Rishi-Saraf/Music-visualiser/figures/fig01_uncertainty.png

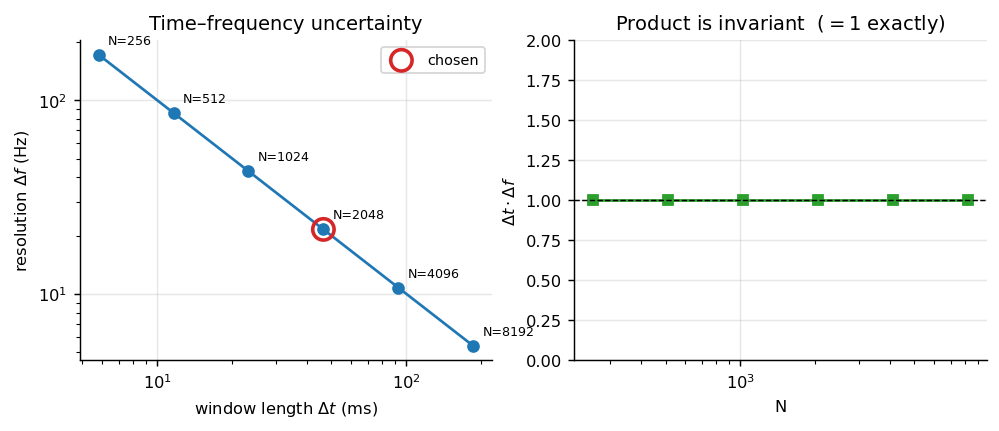
figures/fig01_uncertainty.png
