Rishi-Saraf/Music-visualiser/figures/fig02_window_leakage.png

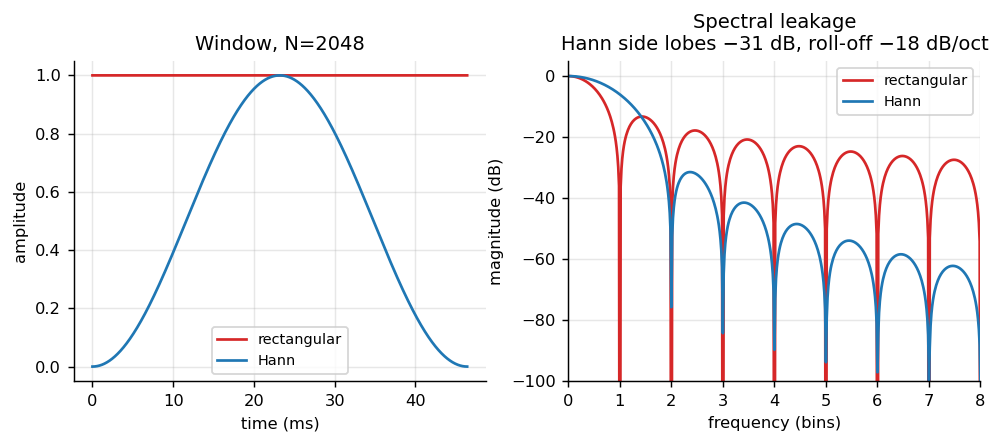
figures/fig02_window_leakage.png
