Rishi-Saraf/Music-visualiser/figures/fig03_spectrogram.png

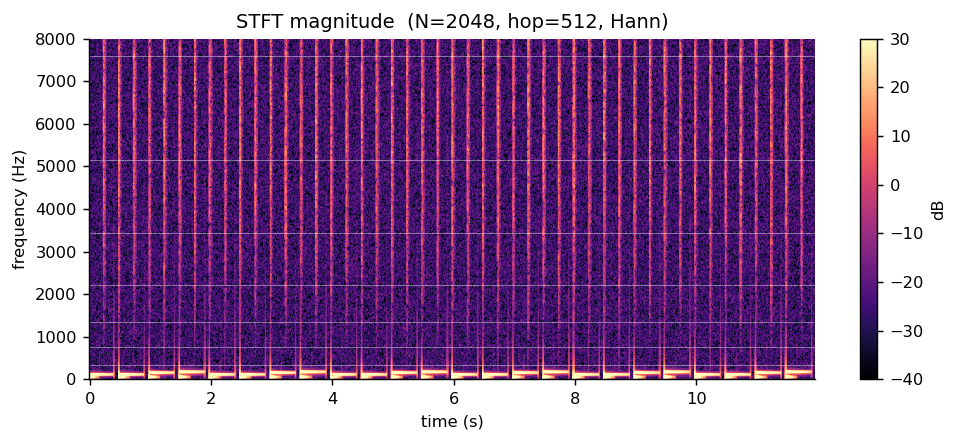
figures/fig03_spectrogram.png
