Rishi-Saraf/Music-visualiser/figures/fig04_filterbank.png

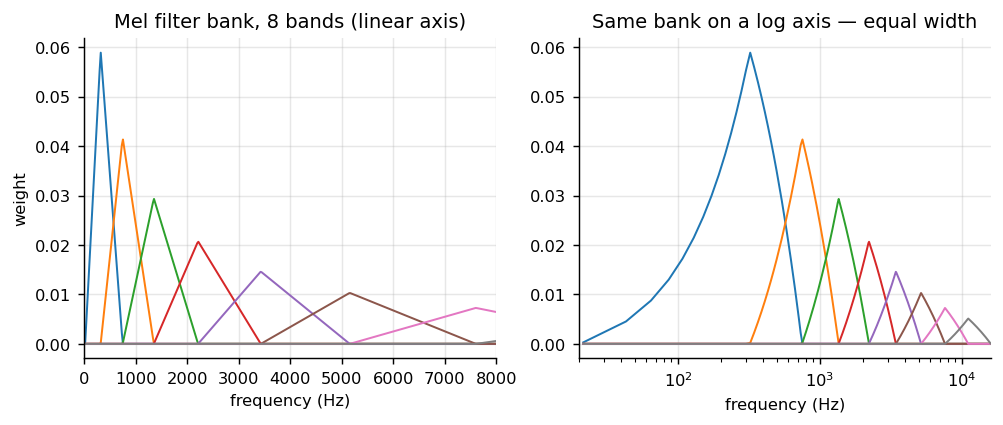
figures/fig04_filterbank.png
