Rishi-Saraf/Music-visualiser/figures/fig05_envelope_lti.png

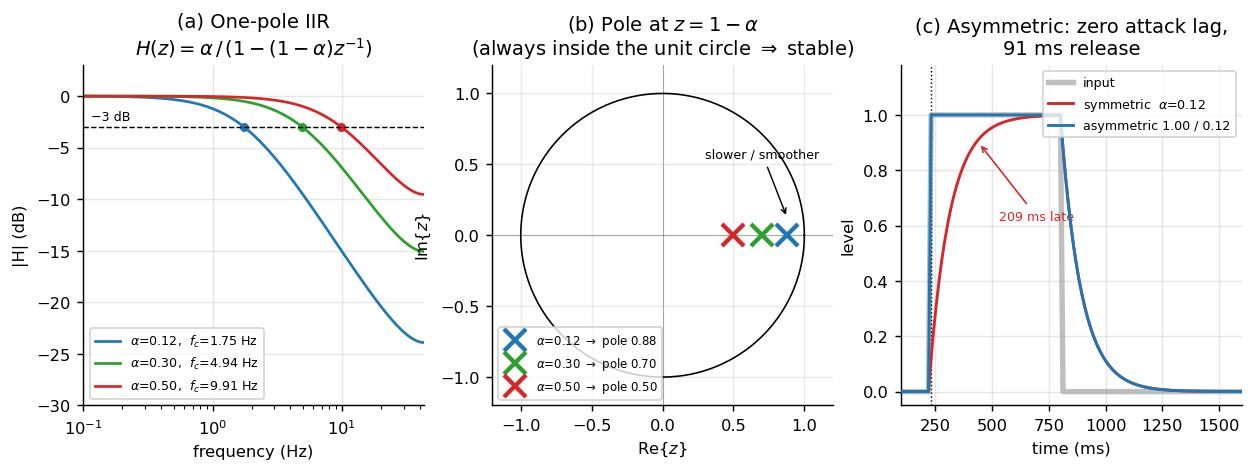
figures/fig05_envelope_lti.png
