Rishi-Saraf/Music-visualiser/figures/fig06_onset_tempo.png

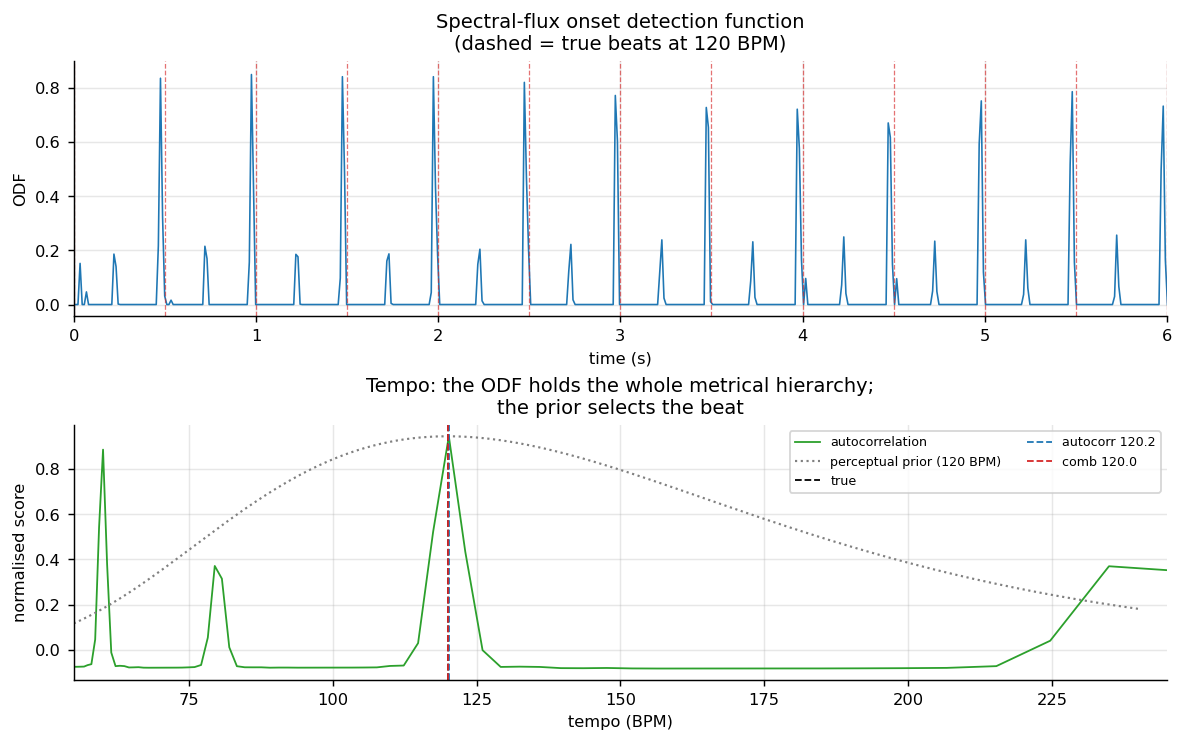
figures/fig06_onset_tempo.png
