Rishi-Saraf/Music-visualiser/figures/fig07_led_waterfall_bars.png

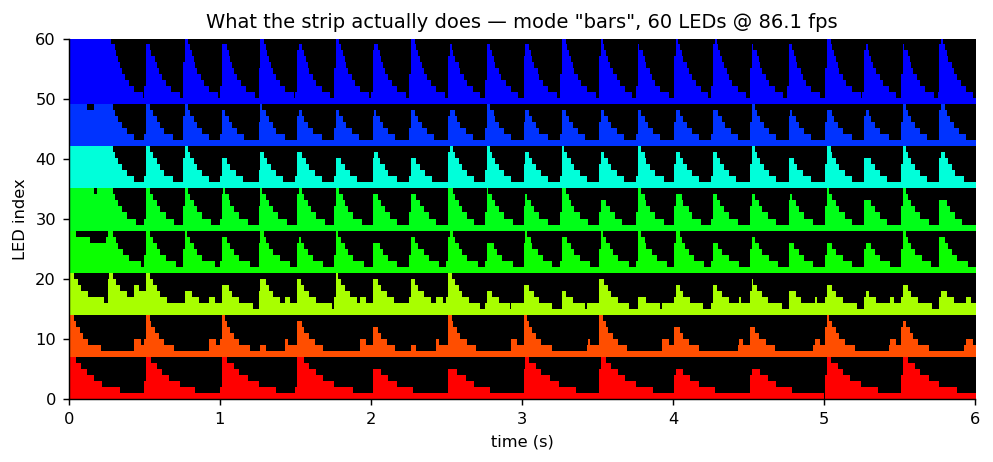
figures/fig07_led_waterfall_bars.png
