Rishi-Saraf/Music-visualiser/figures/fig07_led_waterfall_centroid.png

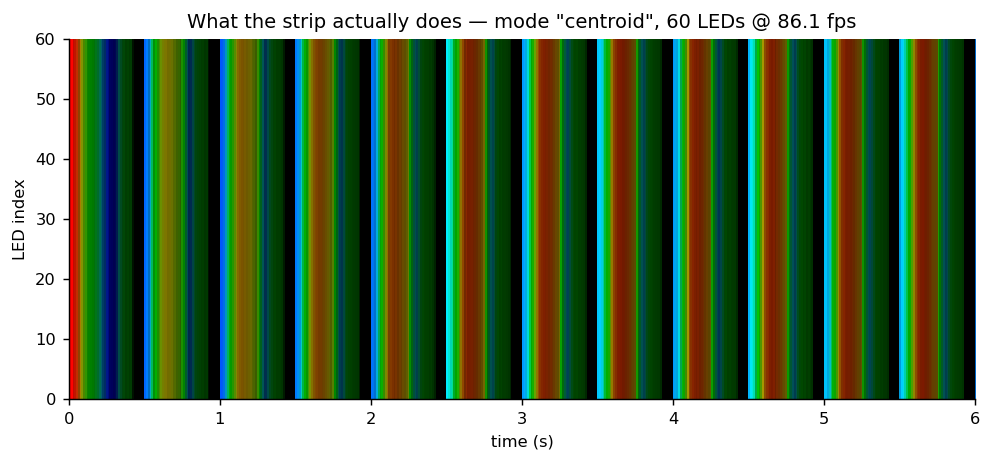
figures/fig07_led_waterfall_centroid.png
