Rishi-Saraf/Music-visualiser/figures/fig07_led_waterfall_pulse.png

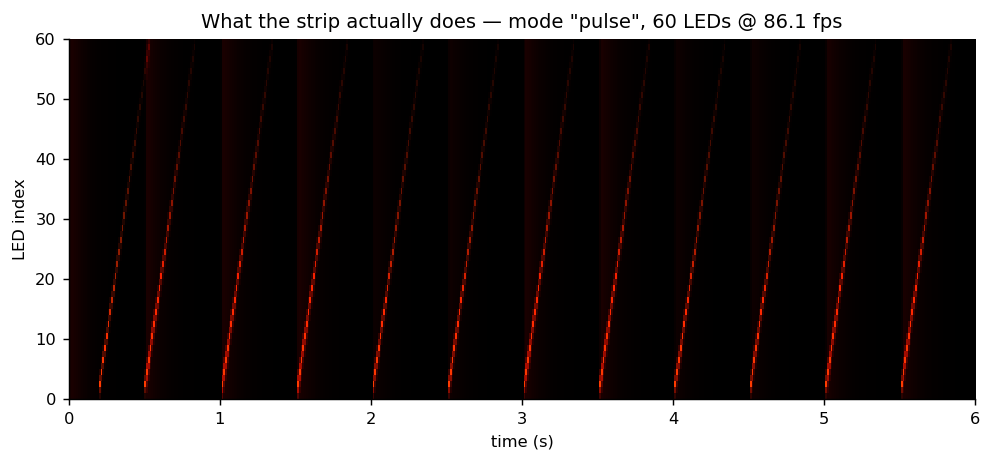
figures/fig07_led_waterfall_pulse.png
