Rishi-Saraf/Music-visualiser/figures/fig08_latency.png

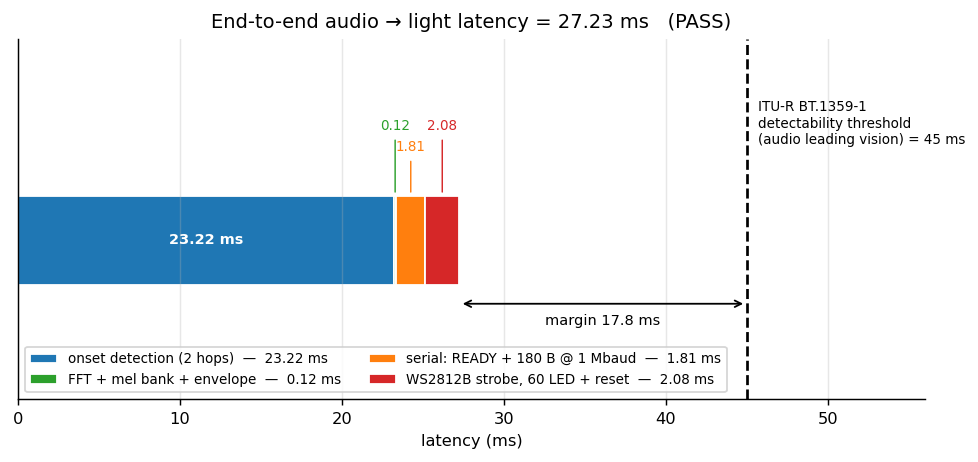
figures/fig08_latency.png
