Rishi-Saraf/Music-visualiser/figures/fig09_pwm_channels.png

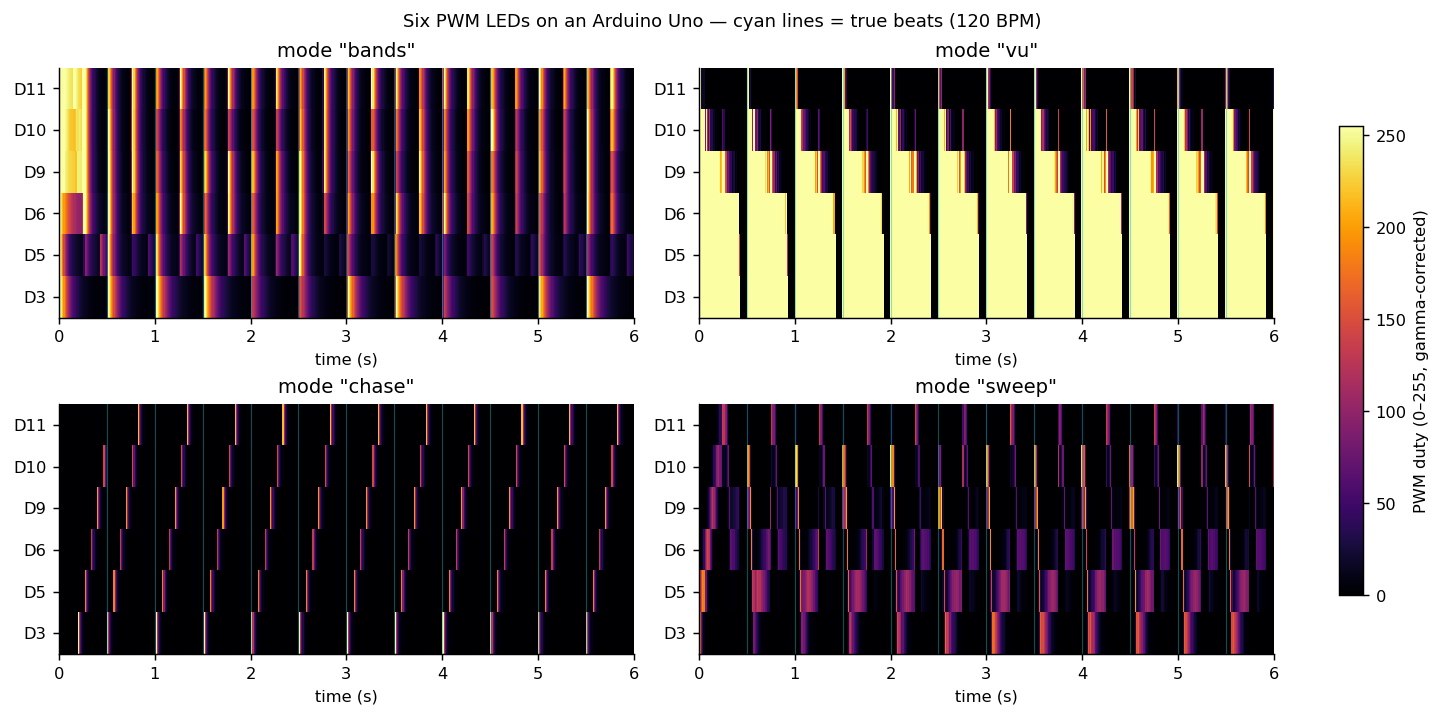
figures/fig09_pwm_channels.png
