Rishi-Saraf/Music-visualiser/figures/fig10_pwm_hardware.png

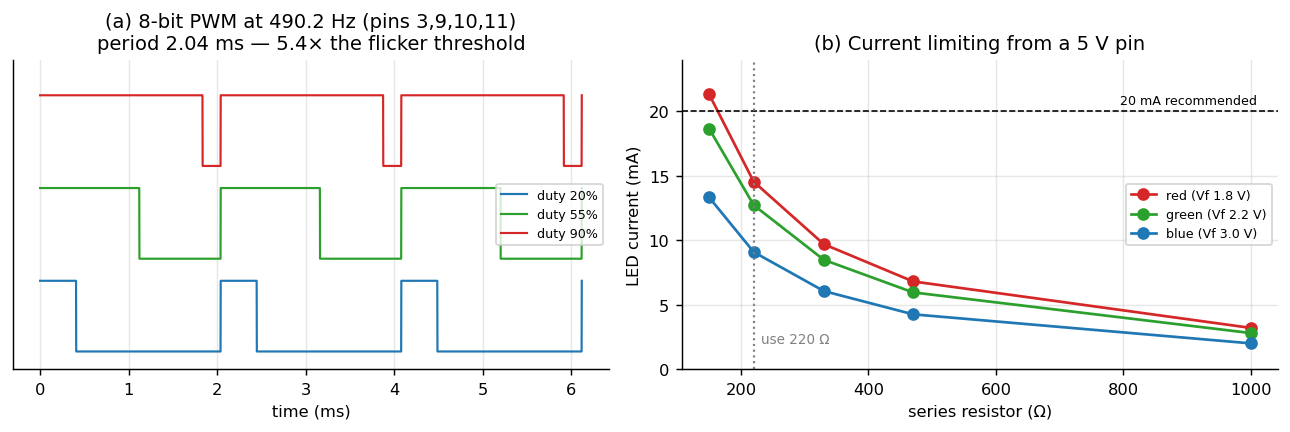
figures/fig10_pwm_hardware.png
