Rishi-Saraf/Music-visualiser/figures/fig11_lcd.png

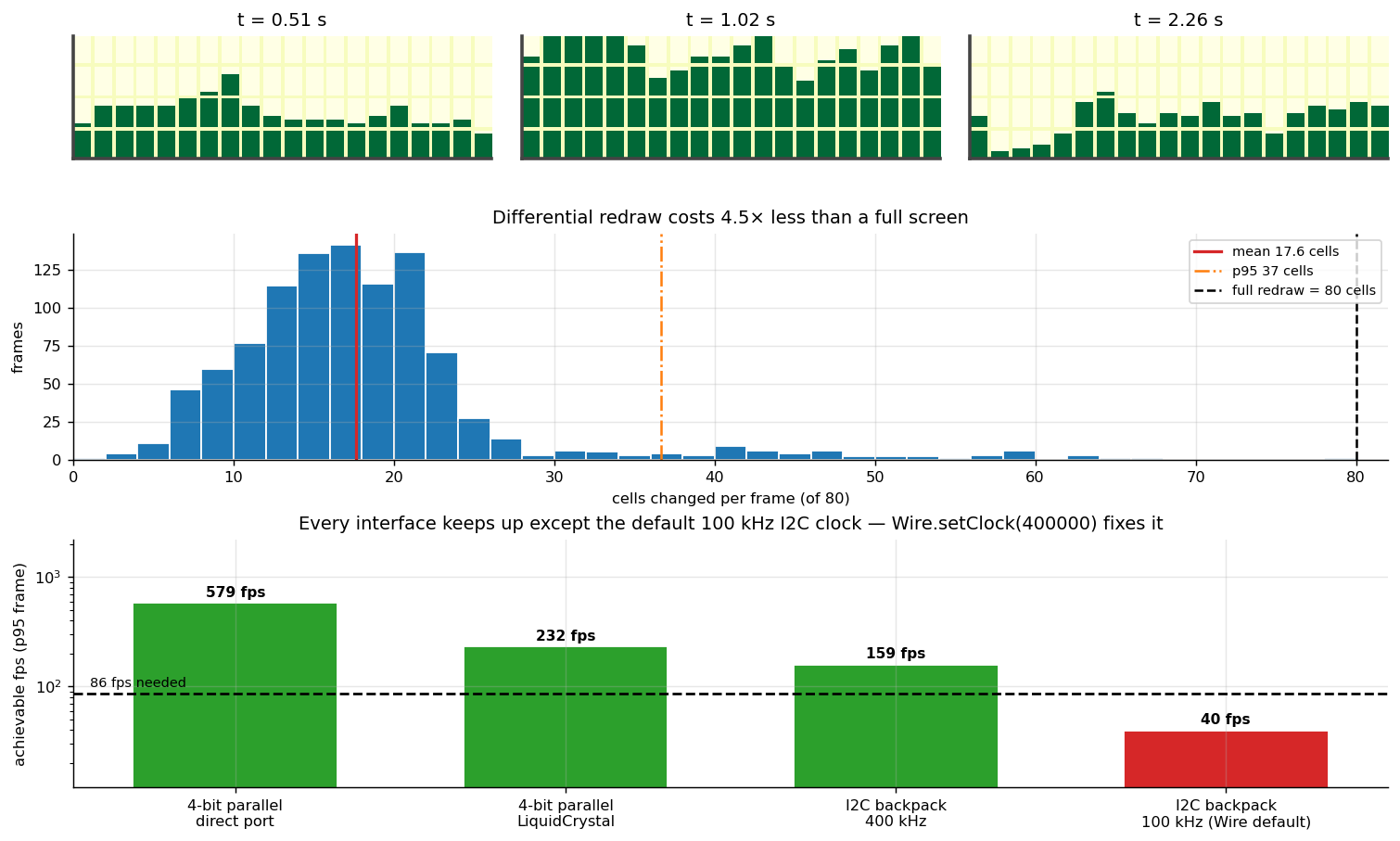
figures/fig11_lcd.png
