Rishi-Saraf/Music-visualiser/figures/fig13_contrast_circuit.png

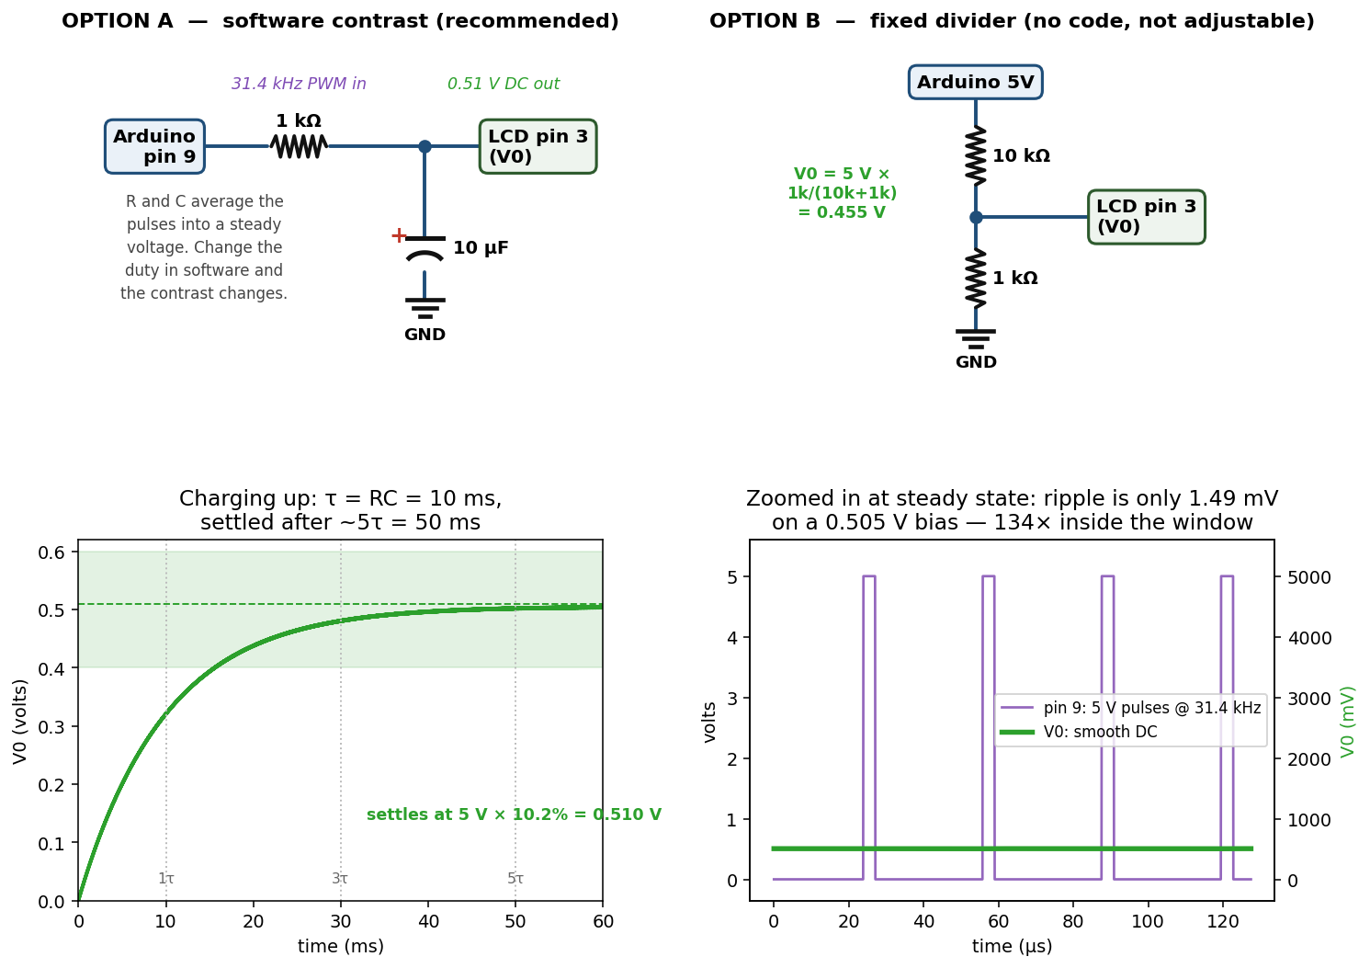
figures/fig13_contrast_circuit.png
