Rishi-Saraf/Music-visualiser/figures/fig12_wiring.png

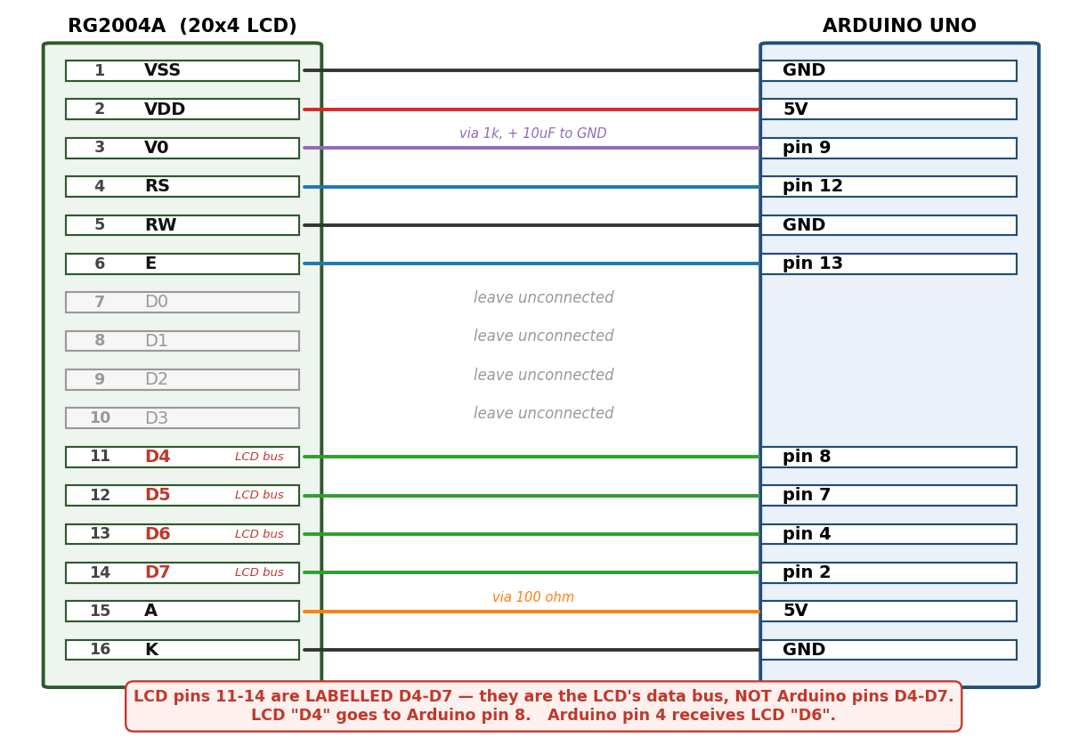
figures/fig12_wiring.png
